pinski1/PQ60-EPS/Hardware/PQ60-EPS.pdf

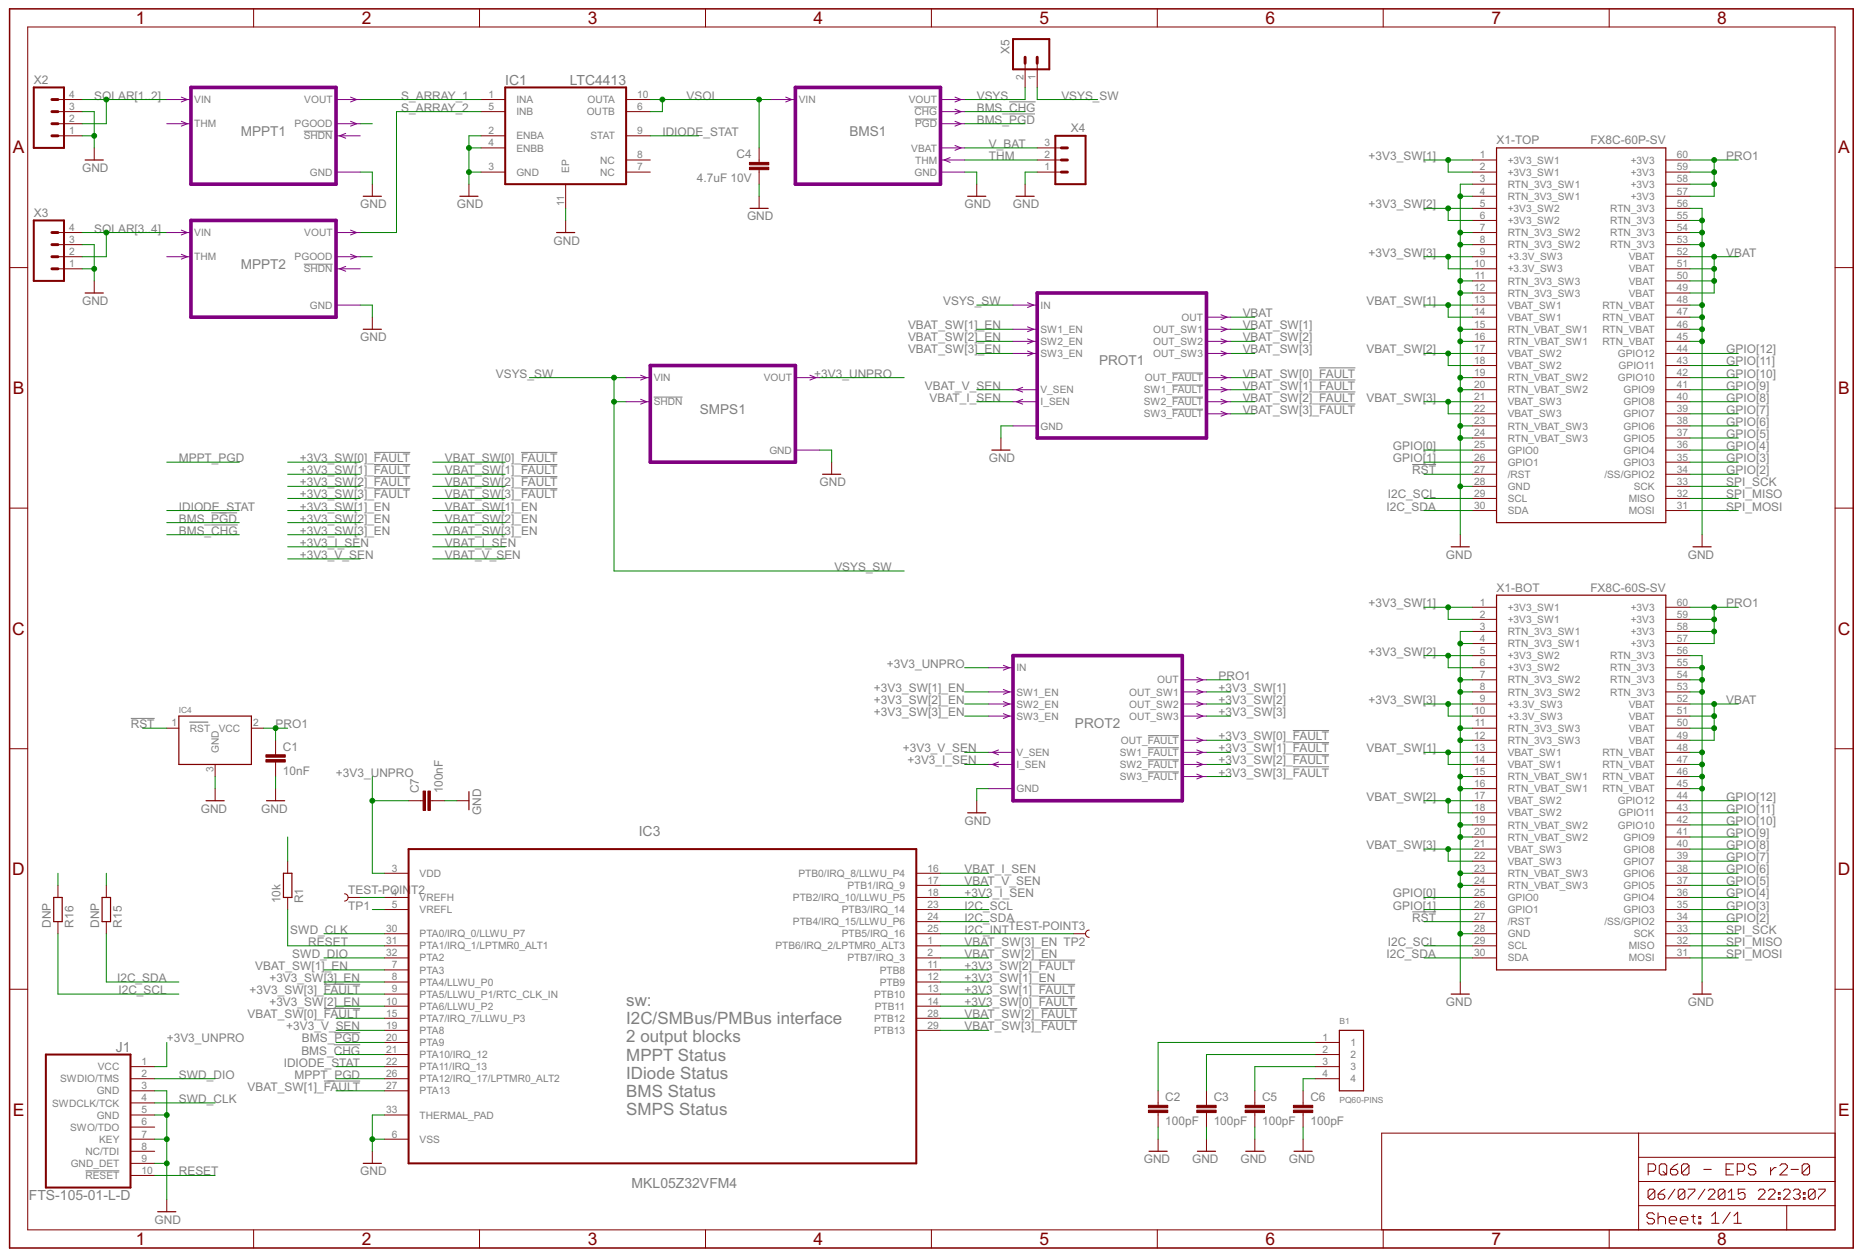
[picture p2: page 1]

51 VBAT

11 | 50 VBAT

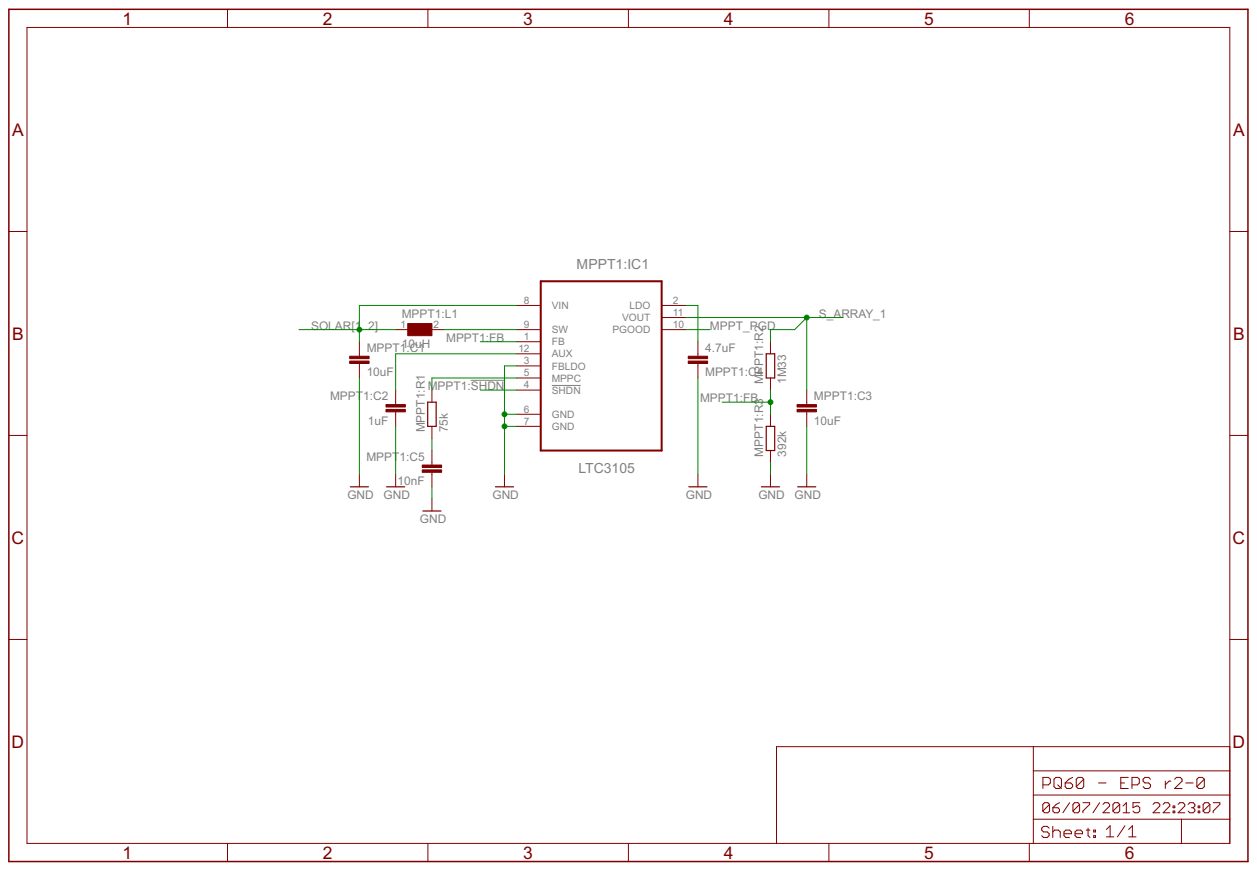
[picture p3: page 2]

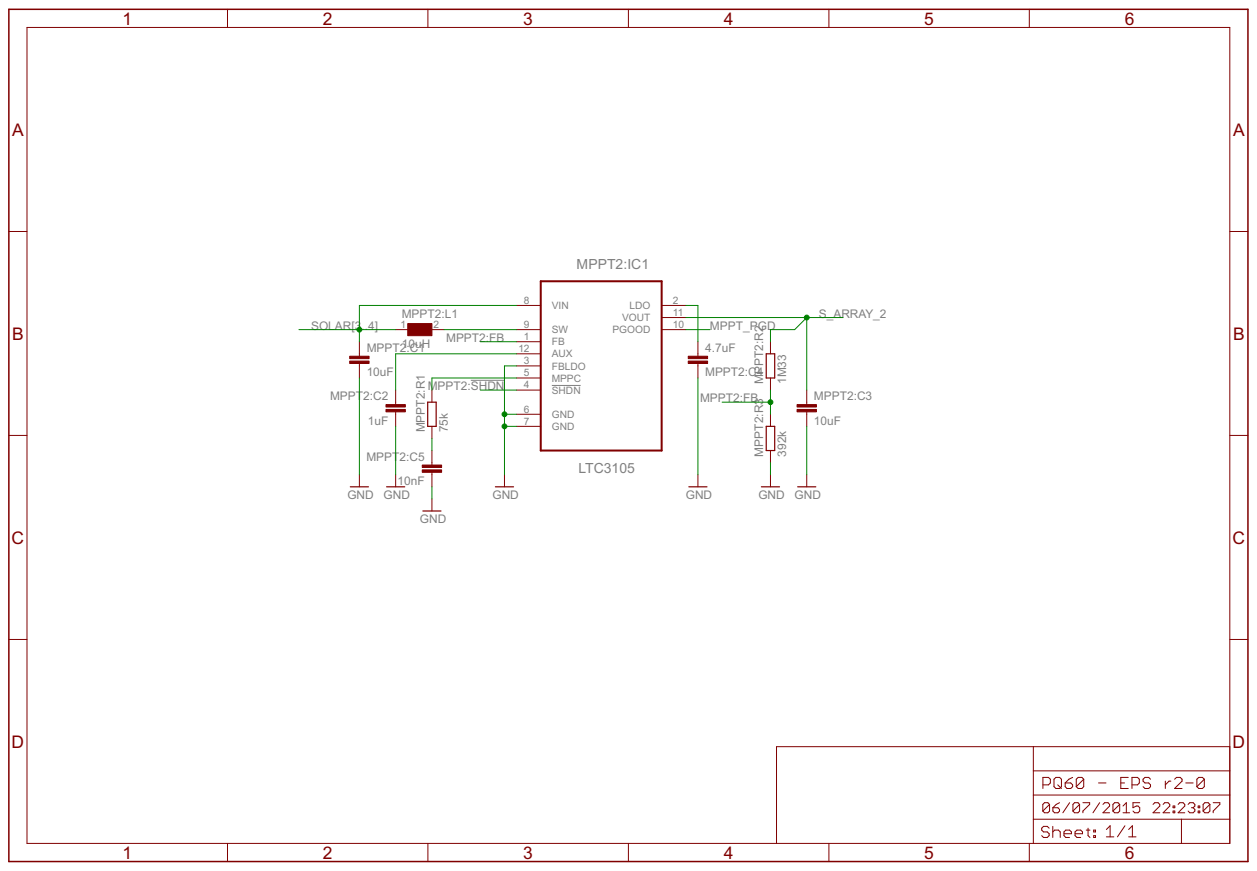
[picture p4: page 3]

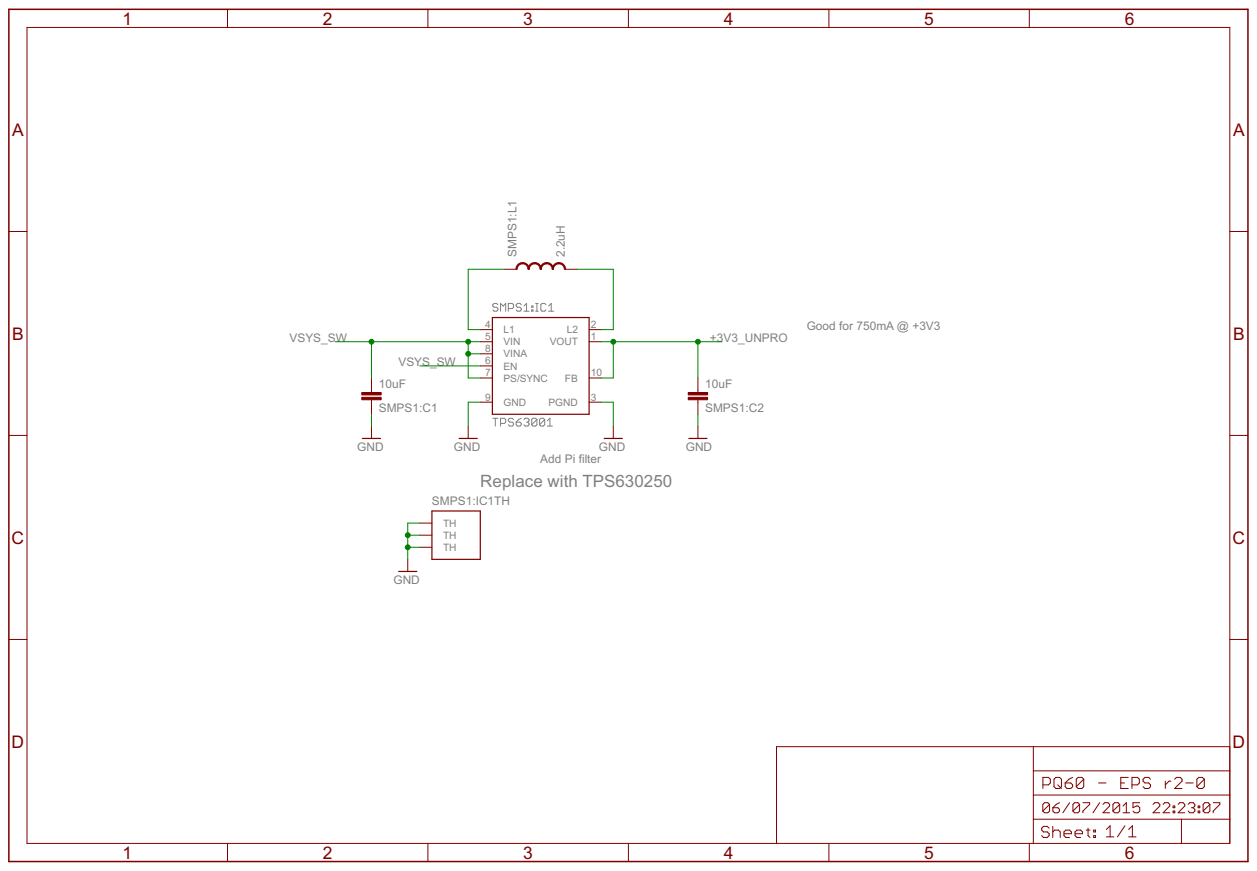
[picture p5: page 4]

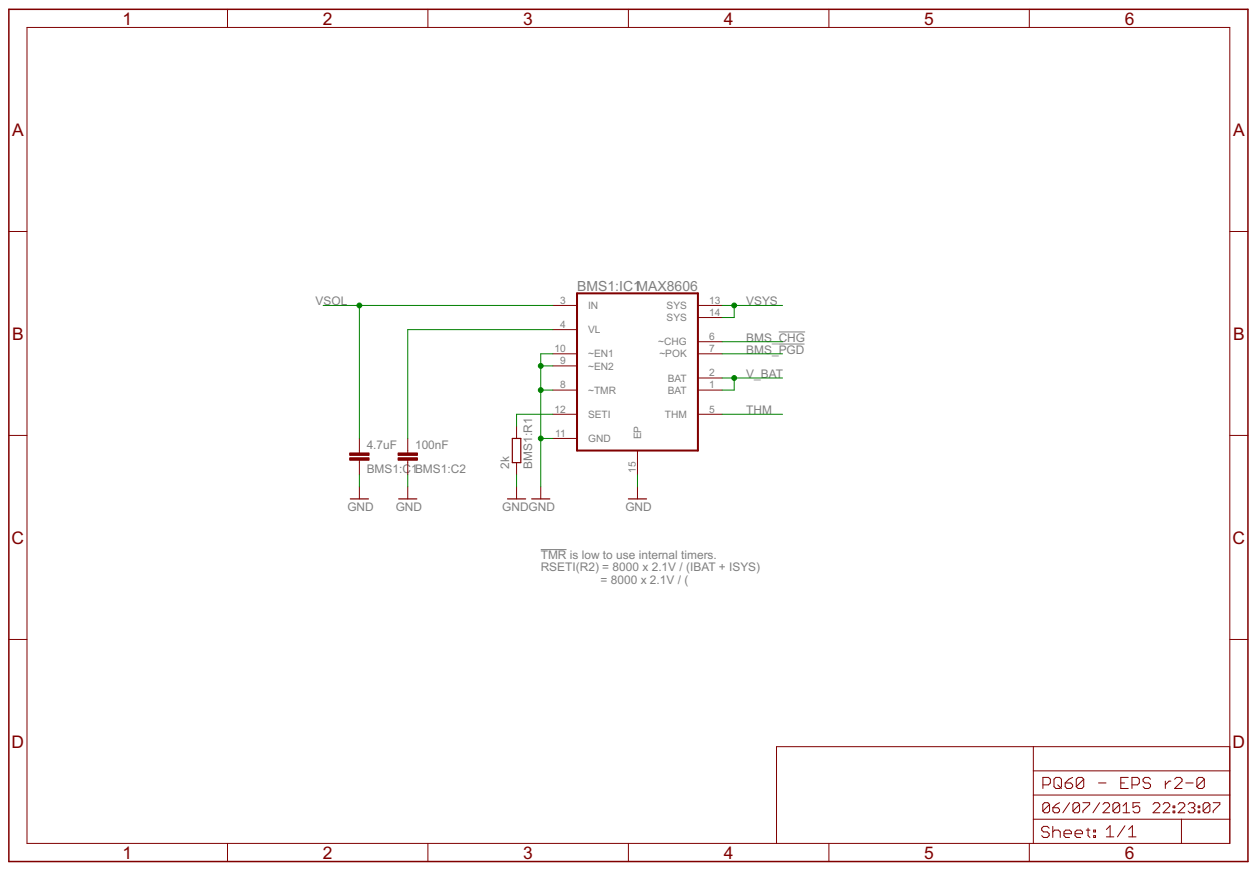
[picture p6: page 5]

TMR is low to use internal timers. RSETI(R2) = 8000 x 2.1V / (IBAT + ISYS) = 8000 x 2.1V / (

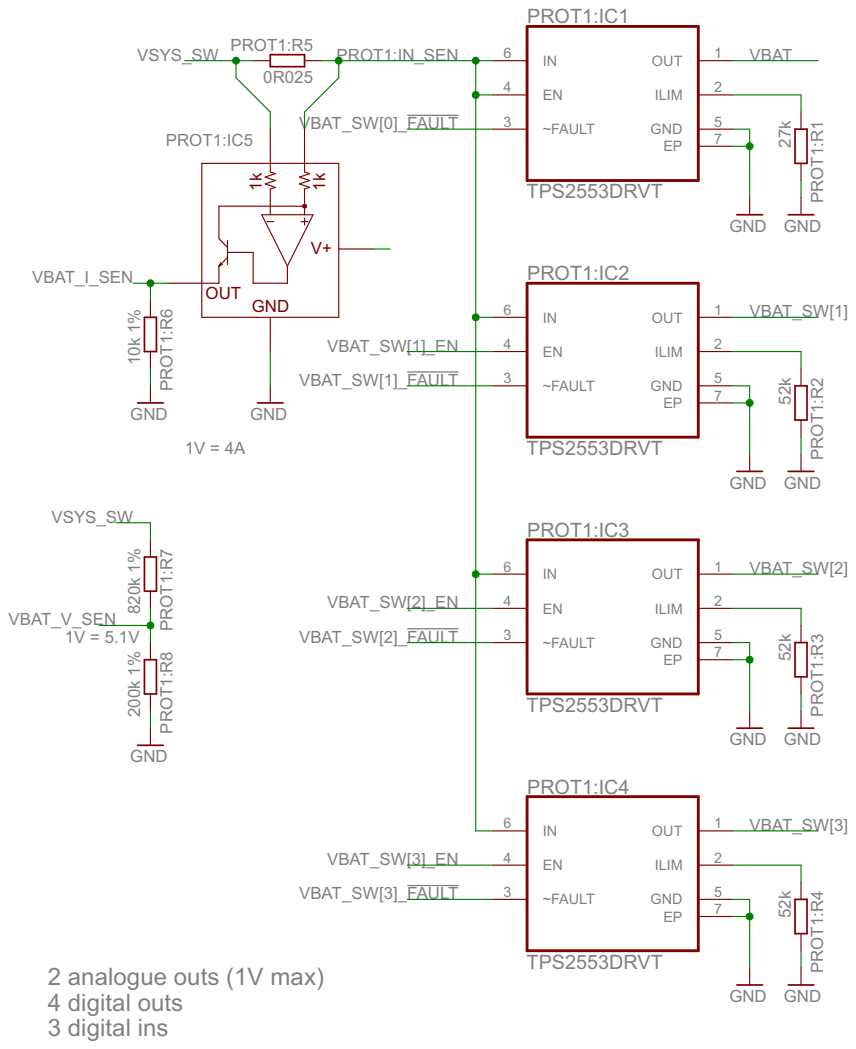
[picture p7: page 6]

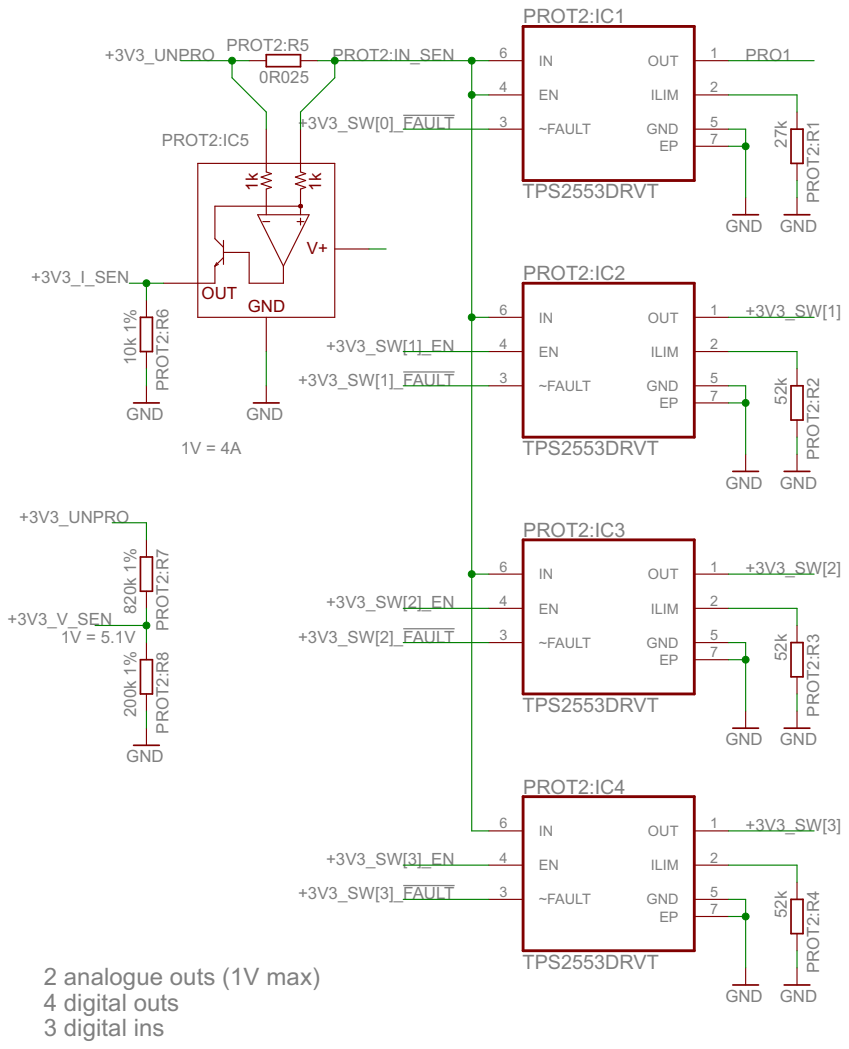
[picture p8: page 7]
