pinski1/PQ60-EPS/Hardware/PQ60-EPS.brd

## EAGLE design Hardware/PQ60-EPS.brd (2015-07-06)

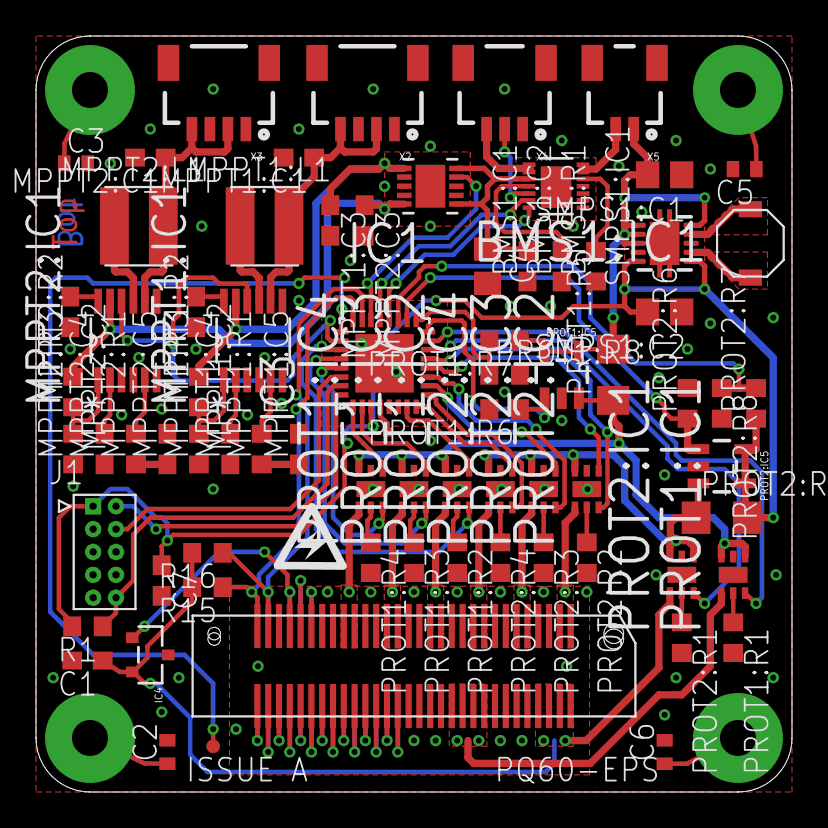
[picture p9: board PQ60-EPS.brd from above]

Board: 2 copper layers, 42.0 x 42.0 mm, 77 parts (1 on the bottom side), 95 nets.

Parts:
B1: PQ60-PINS; PQ60_PINS
BMS1:C1: 4.7uF; C0603
BMS1:C2: 100nF; C0603
BMS1:IC1: MAX8606; DFN300X300X80-15N
BMS1:R1: 2k; R0603
C1: 10nF; C0603
C2, C3, C5, C6: 100pF; C0402
C4: 4.7uF 10V; C0805
C7: 100nF; C0603
IC1: LTC4413; DFN300X300X80-11N
IC3: MKL05Z32VFM4; QFN50P500X500X100-33N
IC4: SOT23-R
J1: FTS-105-01-L-D; SAMTEC_FTS-105-01-L-D
MPPT1:C1, MPPT1:C3, MPPT2:C1, MPPT2:C3: 10uF; C0603
MPPT1:C2, MPPT2:C2: 1uF; C0603
MPPT1:C4, MPPT2:C4: 4.7uF; C0603
MPPT1:C5, MPPT2:C5: 10nF; C0603
MPPT1:IC1, MPPT2:IC1: LTC3105; SOP65P490X110-12N
MPPT1:L1, MPPT2:L1: 10uH; WE-TPC_3816
MPPT1:R1, MPPT2:R1: 75k; R0603
MPPT1:R2, MPPT2:R2: 1M33; R0603
MPPT1:R3, MPPT2:R3: 392k; R0603
PROT1:IC1, PROT1:IC2, PROT1:IC3, PROT1:IC4, PROT2:IC1, PROT2:IC2, PROT2:IC3, PROT2:IC4: TPS2553DRVT; SON65P200X200X80-7N
PROT1:IC5, PROT2:IC5: SOT23-5
PROT1:R1, PROT2:R1: 27k; R0603
PROT1:R2, PROT1:R3, PROT1:R4, PROT2:R2, PROT2:R3, PROT2:R4: 52k; R0603
PROT1:R5, PROT2:R5: 0R025; R1206
PROT1:R6, PROT2:R6: 10k 1%; R0603
PROT1:R7, PROT2:R7: 820k 1%; R0603
PROT1:R8, PROT2:R8: 200k 1%; R0603
R1: 10k; R0603
R15, R16: DNP; R0603
SMPS1:C1, SMPS1:C2: 10uF; C0805
SMPS1:IC1: TPS63001; DRC-S-PVSON-N10
SMPS1:L1: 2.2uH; VLF4012A
TP1: TEST-POINT2; PAD.02X.02
TP2: TEST-POINT3; PAD.03X.03
X1-BOT: FX8C-60S-SV
X1-TOP: FX8C-60P-SV
X2, X3: 1X04-1MM-RA
X4: 1X03-1MM-RA
X5: 1X02-1MM-RA

Connections:
!RST: IC4.1, X1-BOT.27, X1-TOP.27
+3V3_I_SEN: IC3.18, PROT2:IC5.1, PROT2:R6.1
+3V3_SW[0]_!FAULT!: IC3.14, PROT2:IC1.3
+3V3_SW[1]: PROT2:IC2.1, X1-BOT.1, X1-BOT.2, X1-TOP.1, X1-TOP.2
+3V3_SW[1]_!FAULT!: IC3.13, PROT2:IC2.3
+3V3_SW[1]_EN: IC3.12, PROT2:IC2.4
+3V3_SW[2]: PROT2:IC3.1, X1-BOT.5, X1-BOT.6, X1-TOP.5, X1-TOP.6
+3V3_SW[2]_!FAULT!: IC3.11, PROT2:IC3.3
+3V3_SW[2]_EN: IC3.10, PROT2:IC3.4
+3V3_SW[3]: PROT2:IC4.1, X1-BOT.9, X1-BOT.10, X1-TOP.9, X1-TOP.10
+3V3_SW[3]_!FAULT!: IC3.9, PROT2:IC4.3
+3V3_SW[3]_EN: IC3.8, PROT2:IC4.4
+3V3_UNPRO: C7.1, IC3.3, J1.1, PROT2:IC5.4, PROT2:IC5.5, PROT2:R5.2, PROT2:R7.1, R1.2, SMPS1:C2.2, SMPS1:IC1.1, SMPS1:IC1.10
+3V3_V_SEN: IC3.19, PROT2:R7.2, PROT2:R8.1
BMS1:BATT_PROG: BMS1:IC1.12, BMS1:R1.2
BMS1:VL: BMS1:C2.2, BMS1:IC1.4
BMS_!CHG!: BMS1:IC1.6, IC3.21
BMS_!PGD!: BMS1:IC1.7, IC3.20
GND: BMS1:C1.1, BMS1:C2.1, BMS1:IC1.8, BMS1:IC1.9, BMS1:IC1.10, BMS1:IC1.11, BMS1:IC1.15, BMS1:R1.1, C1.2, C2.2, C3.2, C4.2, C5.2, C6.2, C7.2, IC1.2, IC1.3, IC1.4, IC1.11, IC3.5, IC3.6, IC3.33, IC4.3, J1.3, J1.5, J1.7, J1.9, MPPT1:C1.2, MPPT1:C2.2, MPPT1:C3.2, MPPT1:C4.1, MPPT1:C5.2, MPPT1:IC1.3, MPPT1:IC1.6, MPPT1:IC1.7, MPPT1:R3.1, MPPT2:C1.2, MPPT2:C2.2, MPPT2:C3.2, MPPT2:C4.1, MPPT2:C5.2, MPPT2:IC1.3, MPPT2:IC1.6, MPPT2:IC1.7, MPPT2:R3.1, PROT1:IC1.5, PROT1:IC1.7, PROT1:IC2.5, PROT1:IC2.7, PROT1:IC3.5, PROT1:IC3.7, PROT1:IC4.5, PROT1:IC4.7, PROT1:IC5.2, PROT1:R1.2, PROT1:R2.2, PROT1:R3.2, PROT1:R4.2, PROT1:R6.2, PROT1:R8.2, PROT2:IC1.5, PROT2:IC1.7, PROT2:IC2.5, PROT2:IC2.7, PROT2:IC3.5, PROT2:IC3.7, PROT2:IC4.5, PROT2:IC4.7, PROT2:IC5.2, PROT2:R1.2, PROT2:R2.2, PROT2:R3.2, PROT2:R4.2, PROT2:R6.2, PROT2:R8.2, SMPS1:C1.1, SMPS1:C2.1, SMPS1:IC1.3, SMPS1:IC1.9, SMPS1:IC1.TH, SMPS1:IC1.TH@1, SMPS1:IC1.TH@2, X1-BOT.3, X1-BOT.4, X1-BOT.7, X1-BOT.8, X1-BOT.11, X1-BOT.12, X1-BOT.15, X1-BOT.16, X1-BOT.19, X1-BOT.20, X1-BOT.23, X1-BOT.24, X1-BOT.28, X1-BOT.45, X1-BOT.46, X1-BOT.47, X1-BOT.48, X1-BOT.53, X1-BOT.54, X1-BOT.55, X1-BOT.56, X1-TOP.3, X1-TOP.4, X1-TOP.7, X1-TOP.8, X1-TOP.11, X1-TOP.12, X1-TOP.15, X1-TOP.16, X1-TOP.19, X1-TOP.20, X1-TOP.23, X1-TOP.24, X1-TOP.28, X1-TOP.45, X1-TOP.46, X1-TOP.47, X1-TOP.48, X1-TOP.53, X1-TOP.54, X1-TOP.55, X1-TOP.56, X2.1, X2.3, X3.1, X3.3, X4.1
GPIO[0]: X1-BOT.25, X1-TOP.25
GPIO[1]: X1-BOT.26, X1-TOP.26
GPIO[2]: X1-BOT.34, X1-TOP.34
GPIO[3]: X1-BOT.35, X1-TOP.35
GPIO[4]: X1-BOT.36, X1-TOP.36
GPIO[5]: X1-BOT.37, X1-TOP.37
GPIO[6]: X1-BOT.38, X1-TOP.38
GPIO[7]: X1-BOT.39, X1-TOP.39
GPIO[8]: X1-BOT.40, X1-TOP.40
GPIO[9]: X1-BOT.41, X1-TOP.41
GPIO[10]: X1-BOT.42, X1-TOP.42
GPIO[11]: X1-BOT.43, X1-TOP.43
GPIO[12]: X1-BOT.44, X1-TOP.44
I2C_INT: IC3.25, TP2.P$1
I2C_SCL: IC3.23, R16.1, X1-BOT.29, X1-TOP.29
I2C_SDA: IC3.24, R15.1, X1-BOT.30, X1-TOP.30
IDIODE_STAT: IC1.9, IC3.22
MPPT1:AUX: MPPT1:C2.1, MPPT1:IC1.12
MPPT1:FB: MPPT1:IC1.1, MPPT1:R2.1, MPPT1:R3.2
MPPT1:LDO: MPPT1:C4.2, MPPT1:IC1.2
MPPT1:MPPC: MPPT1:IC1.5, MPPT1:R1.2
MPPT1:SW: MPPT1:IC1.9, MPPT1:L1.2
MPPT1:THM: MPPT1:C5.1, MPPT1:R1.1
MPPT2:AUX: MPPT2:C2.1, MPPT2:IC1.12
MPPT2:FB: MPPT2:IC1.1, MPPT2:R2.1, MPPT2:R3.2
MPPT2:LDO: MPPT2:C4.2, MPPT2:IC1.2
MPPT2:MPPC: MPPT2:IC1.5, MPPT2:R1.2
MPPT2:SW: MPPT2:IC1.9, MPPT2:L1.2
MPPT2:THM: MPPT2:C5.1, MPPT2:R1.1
MPPT_PGD: IC3.26, MPPT1:IC1.10, MPPT2:IC1.10
unnamed: B1.1, C2.1
unnamed: B1.2, C3.1
unnamed: B1.3, C5.1
unnamed: B1.4, C6.1
unnamed: IC3.4, TP1.P$1
PRO1: C1.1, IC4.2, PROT2:IC1.1, R15.2, R16.2, X1-BOT.57, X1-BOT.58, X1-BOT.59, X1-BOT.60, X1-TOP.57, X1-TOP.58, X1-TOP.59, X1-TOP.60
PROT1:IN_SEN: PROT1:IC1.4, PROT1:IC1.6, PROT1:IC2.6, PROT1:IC3.6, PROT1:IC4.6, PROT1:IC5.3, PROT1:R5.1
PROT1:I_LIM_SW1: PROT1:IC2.2, PROT1:R2.1
PROT1:I_LIM_SW2: PROT1:IC3.2, PROT1:R3.1
PROT1:I_LIM_SW3: PROT1:IC4.2, PROT1:R4.1
PROT1:I_LIM_VCC: PROT1:IC1.2, PROT1:R1.1
PROT2:IN_SEN: PROT2:IC1.4, PROT2:IC1.6, PROT2:IC2.6, PROT2:IC3.6, PROT2:IC4.6, PROT2:IC5.3, PROT2:R5.1
PROT2:I_LIM_SW1: PROT2:IC2.2, PROT2:R2.1
PROT2:I_LIM_SW2: PROT2:IC3.2, PROT2:R3.1
PROT2:I_LIM_SW3: PROT2:IC4.2, PROT2:R4.1
PROT2:I_LIM_VCC: PROT2:IC1.2, PROT2:R1.1
RESET: IC3.31, J1.10, R1.1
SMPS1:N$1: SMPS1:IC1.4, SMPS1:L1.P$1
SMPS1:N$2: SMPS1:IC1.2, SMPS1:L1.P$2
SOLAR[1..2]: MPPT1:C1.1, MPPT1:IC1.8, MPPT1:L1.1, X2.2, X2.4
SOLAR[3..4]: MPPT2:C1.1, MPPT2:IC1.8, MPPT2:L1.1, X3.2, X3.4
SPI_MISO: X1-BOT.32, X1-TOP.32
SPI_MOSI: X1-BOT.31, X1-TOP.31
SPI_SCK: X1-BOT.33, X1-TOP.33
SWD_CLK: IC3.30, J1.4
SWD_DIO: IC3.32, J1.2
S_ARRAY_1: IC1.1, MPPT1:C3.1, MPPT1:IC1.11, MPPT1:R2.2
S_ARRAY_2: IC1.5, MPPT2:C3.1, MPPT2:IC1.11, MPPT2:R2.2
THM: BMS1:IC1.5, X4.2
VBAT: PROT1:IC1.1, X1-BOT.49, X1-BOT.50, X1-BOT.51, X1-BOT.52, X1-TOP.49, X1-TOP.50, X1-TOP.51, X1-TOP.52
VBAT_I_SEN: IC3.16, PROT1:IC5.1, PROT1:R6.1
VBAT_SW[0]_!FAULT!: IC3.15, PROT1:IC1.3
VBAT_SW[1]: PROT1:IC2.1, X1-BOT.13, X1-BOT.14, X1-TOP.13, X1-TOP.14
VBAT_SW[1]_!FAULT!: IC3.27, PROT1:IC2.3
VBAT_SW[1]_EN: IC3.7, PROT1:IC2.4
VBAT_SW[2]: PROT1:IC3.1, X1-BOT.17, X1-BOT.18, X1-TOP.17, X1-TOP.18
VBAT_SW[2]_!FAULT!: IC3.28, PROT1:IC3.3
VBAT_SW[2]_EN: IC3.2, PROT1:IC3.4
VBAT_SW[3]: PROT1:IC4.1, X1-BOT.21, X1-BOT.22, X1-TOP.21, X1-TOP.22
VBAT_SW[3]_!FAULT!: IC3.29, PROT1:IC4.3
VBAT_SW[3]_EN: IC3.1, PROT1:IC4.4
VBAT_V_SEN: IC3.17, PROT1:R7.2, PROT1:R8.1
VSOL: BMS1:C1.2, BMS1:IC1.3, C4.1, IC1.6, IC1.10
VSYS: BMS1:IC1.13, BMS1:IC1.14, X5.2
VSYS_SW: PROT1:IC5.4, PROT1:IC5.5, PROT1:R5.2, PROT1:R7.1, SMPS1:C1.2, SMPS1:IC1.5, SMPS1:IC1.6, SMPS1:IC1.7, SMPS1:IC1.8, X5.1
V_BAT: BMS1:IC1.1, BMS1:IC1.2, X4.3
