pinski1/PQ60-EPS/(threads)

Thread 1 (2021-08-14):

Do you recommend it? Any changes should be used?

ezesculli, 2021-08-14:
Hi there, I'm looking for EPS benchmark for a PocketSat. Do you recommend this? Do you have any feedback about this? Do you have any other open-source recommendation?
I'm looking for something really simple but useful.
Thanks!

pinski1, 2021-08-15:
I never got any further than ordering PCBs and soldering it up. So I wouldn't recommend it at all really.
