pinski1/PQ60-EPS/(commit log)

2015-03-01 Initial file check in.
    [PQ60-EPS.brd, PQ60-EPS.sch]
2015-07-06 Updated to latest PQ60 standard and enhanced circuit,
    [PQ60-EPS.brd, PQ60-EPS.sch]
