pinski1/PQ60-EPS/(notices)

Notices in the files:
parts and their libraries:
SparkFun-Connectors: Licensing: Creative Commons ShareAlike 4.0 International - https://creativecommons.org/licenses/by-sa/4.0
SparkFun march 2012: Licensing: CC v3.0 Share-Alike You are welcome to use this library for commercial purposes.
